kram2106/ascon-crypto-accelerator/docs/reports/connectivity_check.jpg

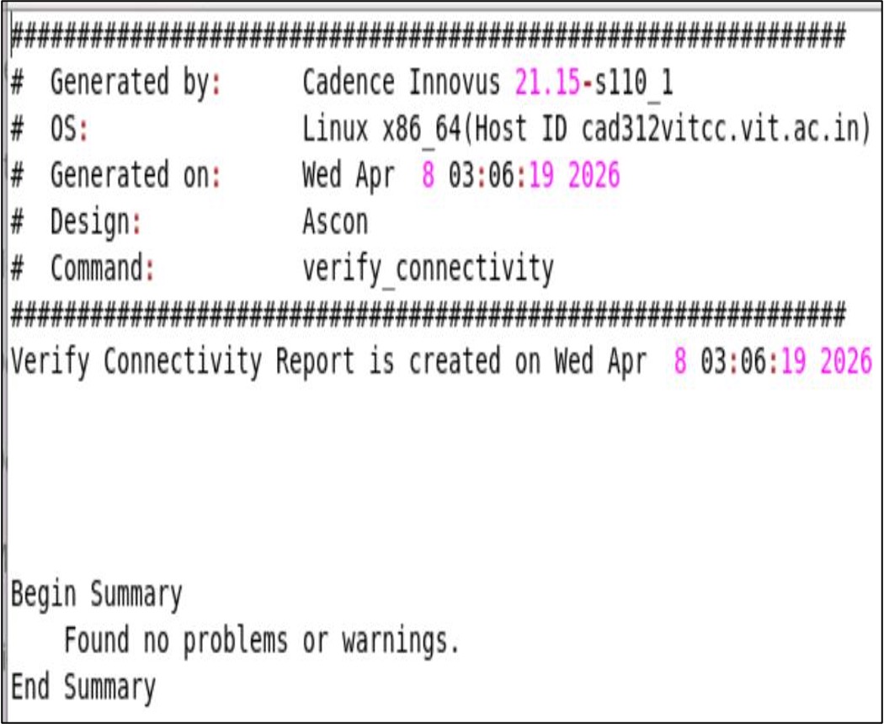
docs/reports/connectivity_check.jpg
