kram2106/ascon-crypto-accelerator/docs/reports/drc.jpg

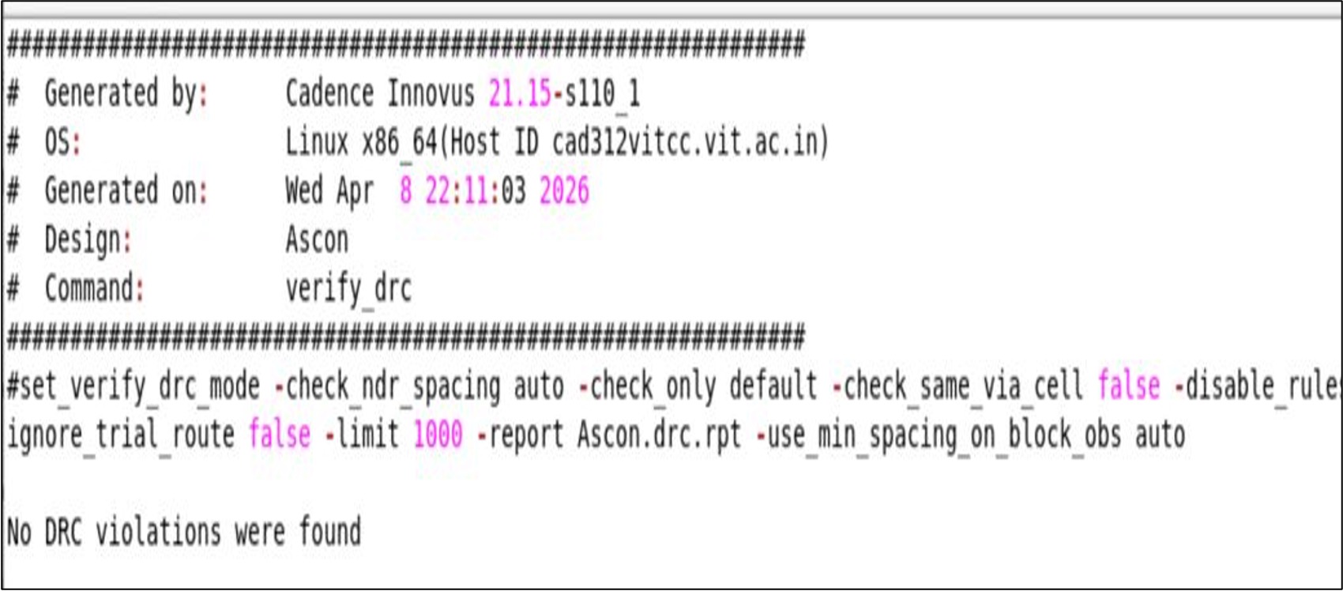
docs/reports/drc.jpg
