kram2106/ascon-crypto-accelerator/docs/reports/geometry_check.jpg

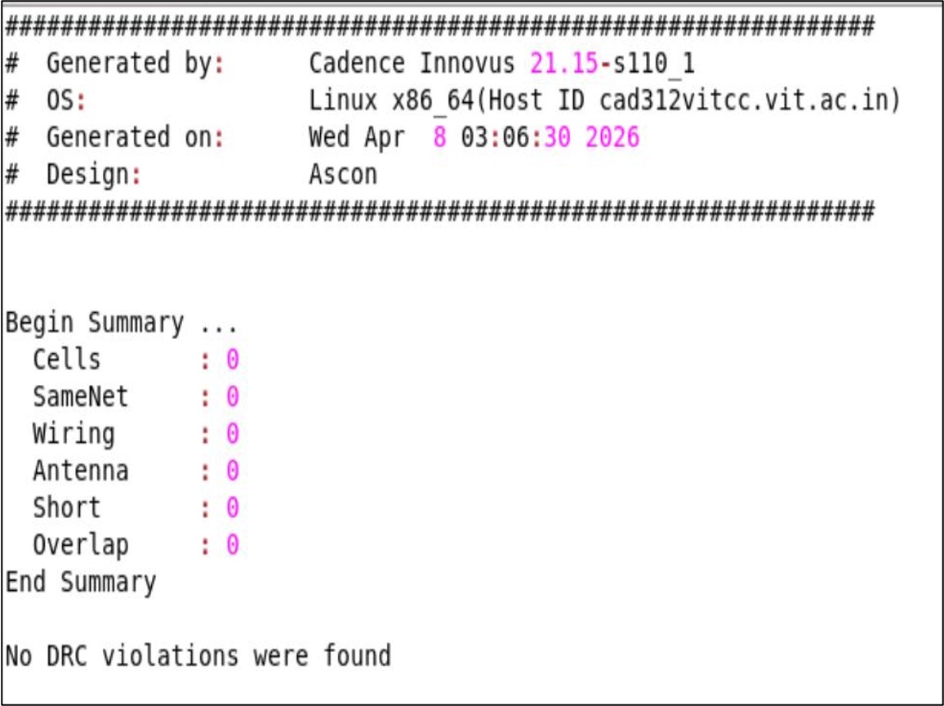
docs/reports/geometry_check.jpg
