kram2106/ascon-crypto-accelerator/docs/reports/post_route_timing.jpg

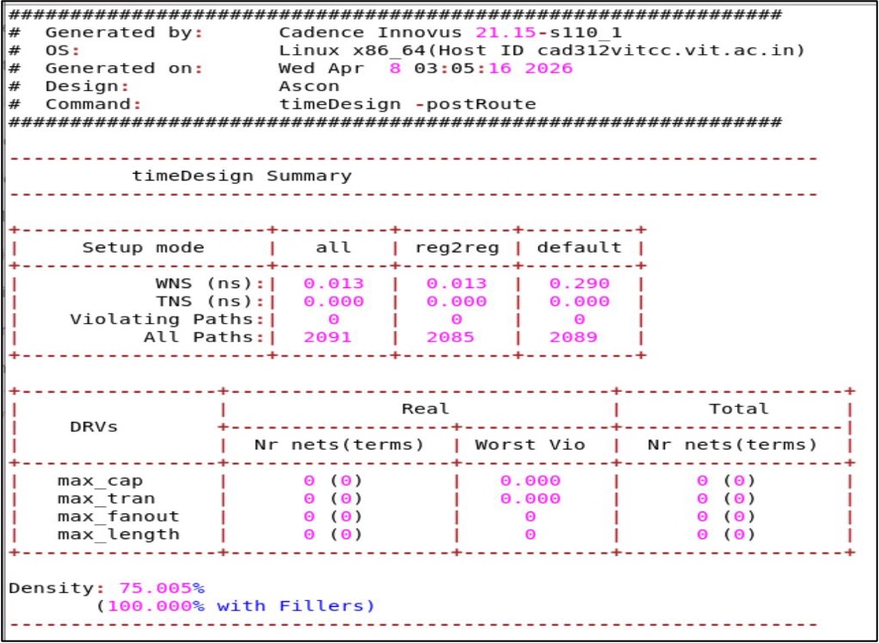
docs/reports/post_route_timing.jpg
