kram2106/ascon-crypto-accelerator/docs/reports/power.jpg

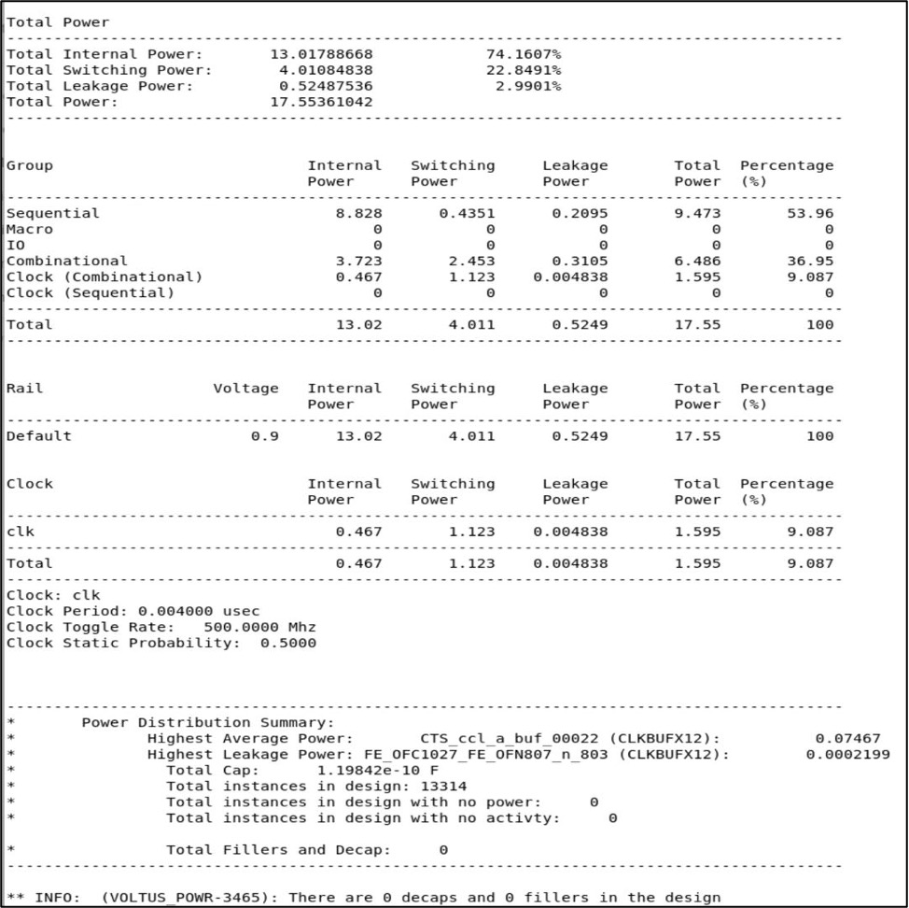
docs/reports/power.jpg
