kram2106/ascon-crypto-accelerator/docs/reports/QoR.jpg

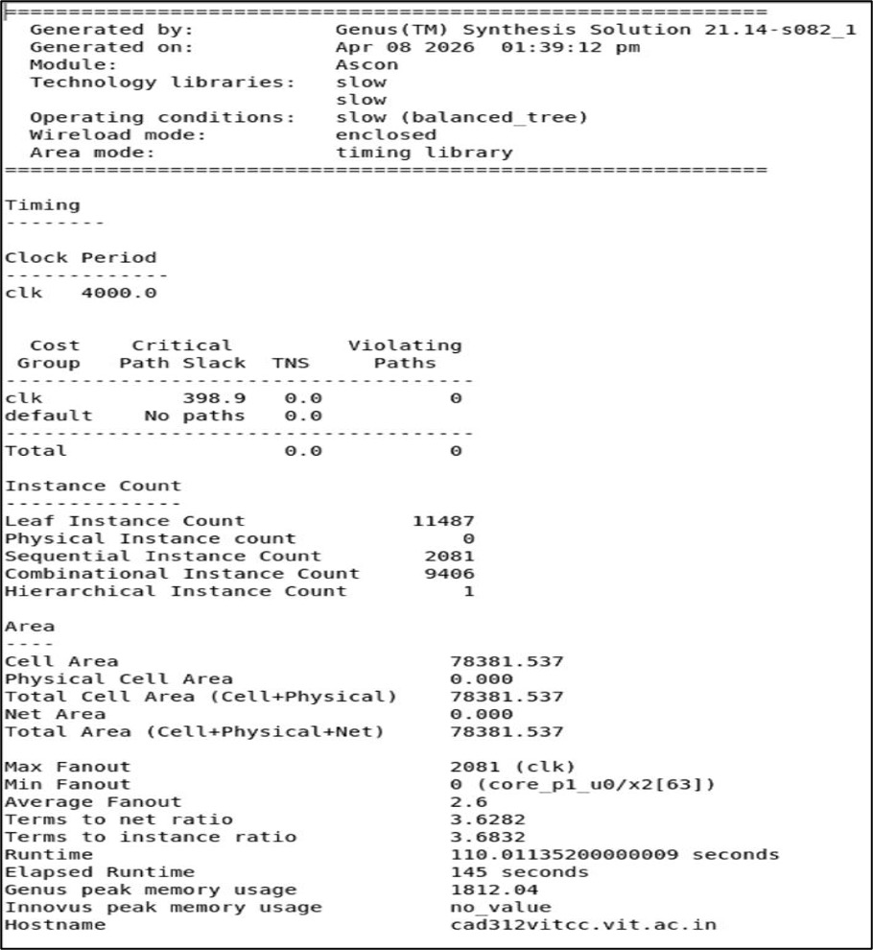
docs/reports/QoR.jpg
